yaz-gear/haptic-feedback-data-glove/hardware/cad_models/3D printed model/picture/final assembly 1.png

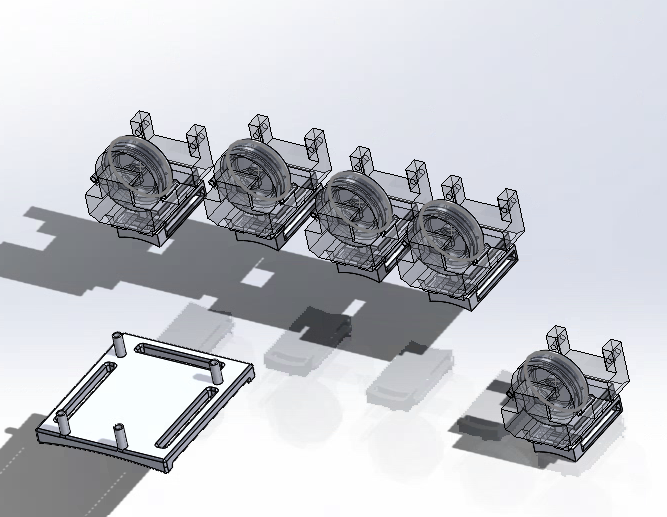
hardware/cad_models/3D printed model/picture/final assembly 1.png
