yaz-gear/haptic-feedback-data-glove/hardware/cad_models/3D printed model/picture/assembly 4.png

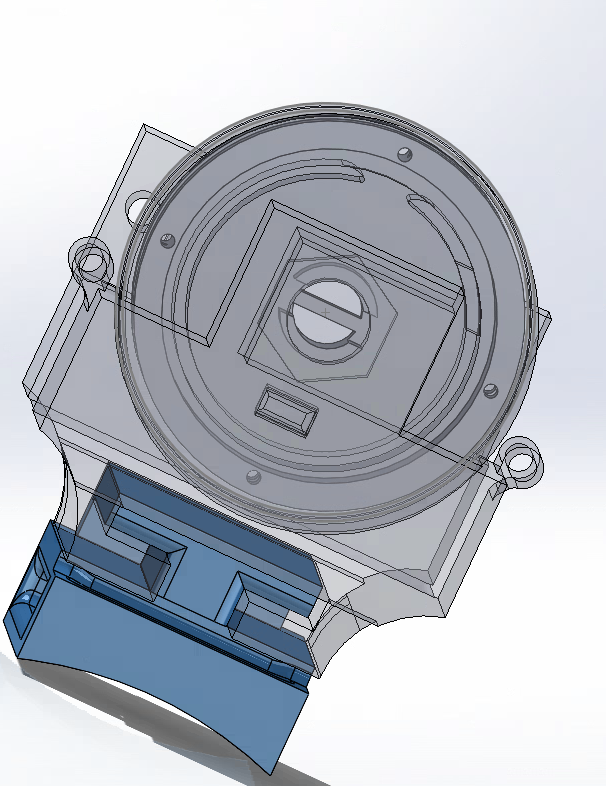
hardware/cad_models/3D printed model/picture/assembly 4.png
