yaz-gear/haptic-feedback-data-glove/docs/demo_images/data closed.jpg

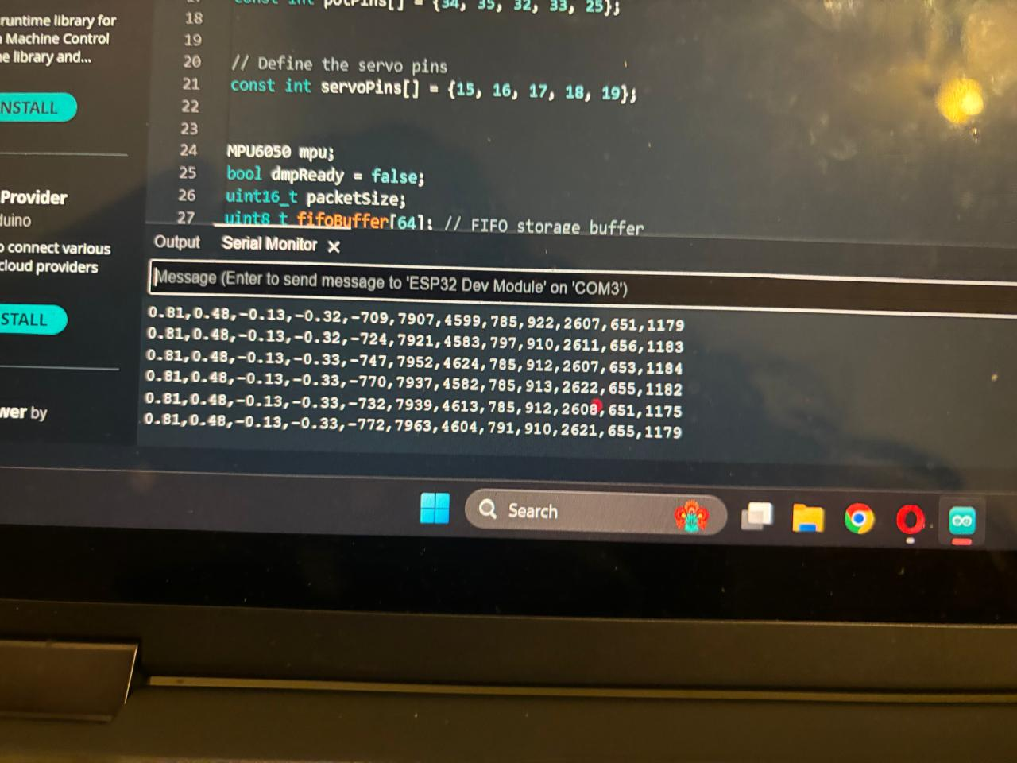
docs/demo_images/data closed.jpg
