yaz-gear/haptic-feedback-data-glove/docs/demo_images/data open.jpg

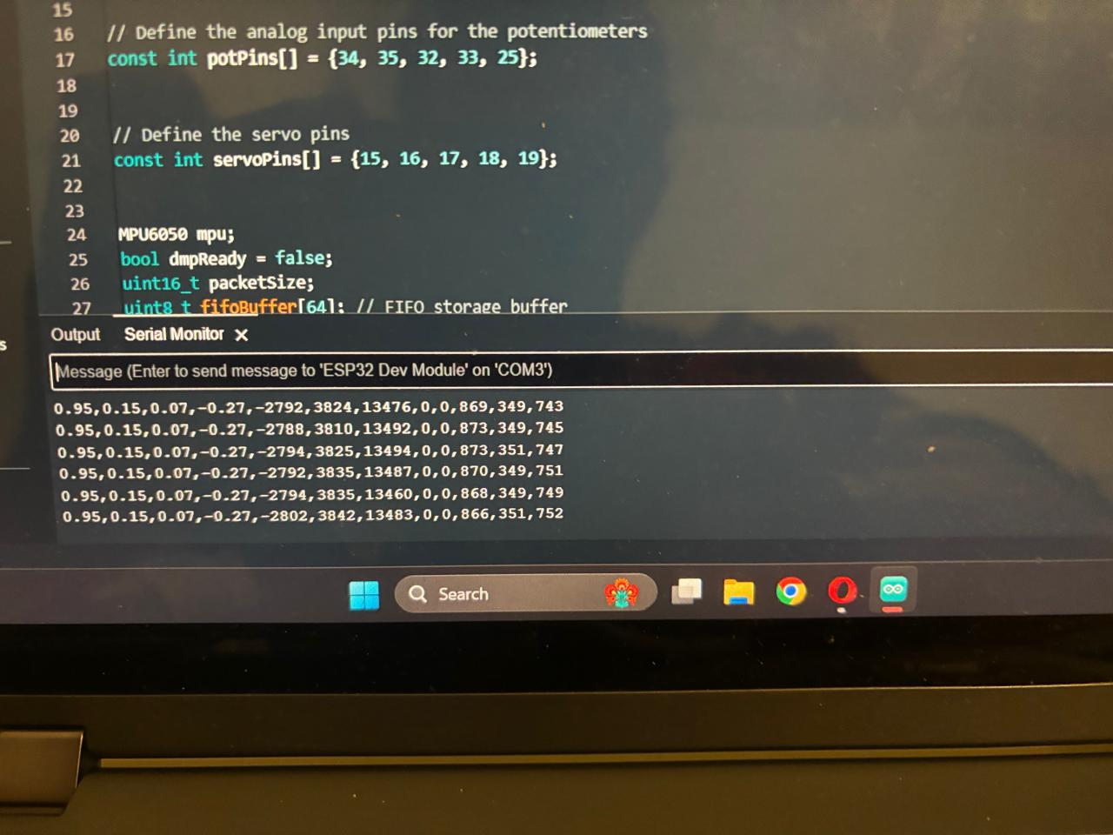
docs/demo_images/data open.jpg
