yaz-gear/haptic-feedback-data-glove/docs/demo_images/final glove closed.jpg

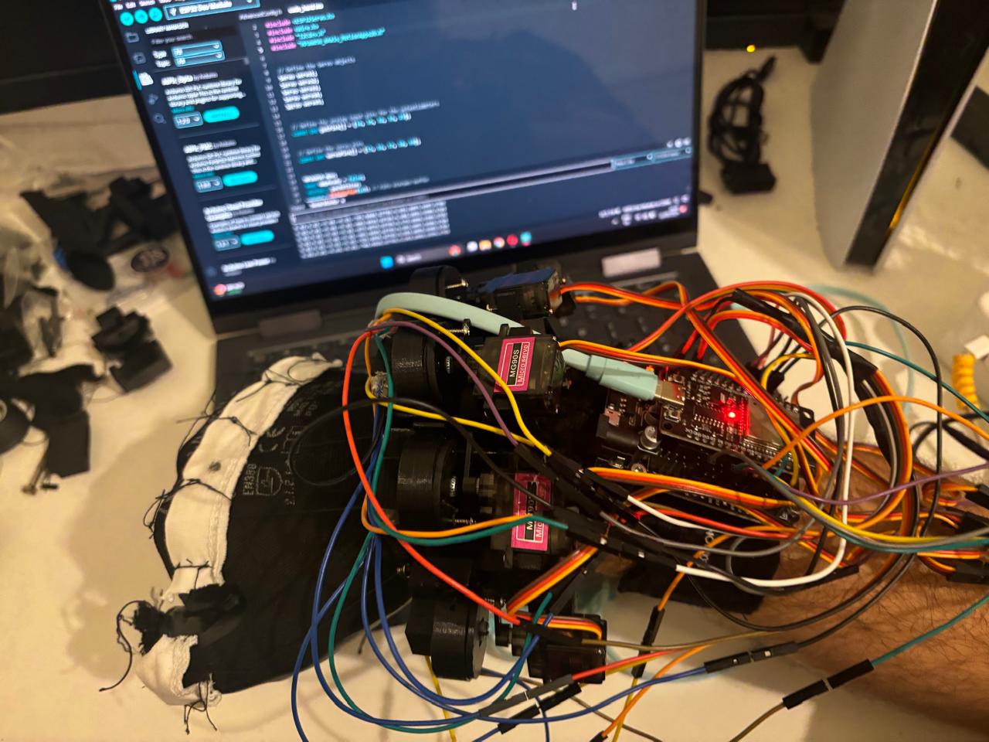
docs/demo_images/final glove closed.jpg
