yaz-gear/haptic-feedback-data-glove/docs/demo_images/final glove open.jpg

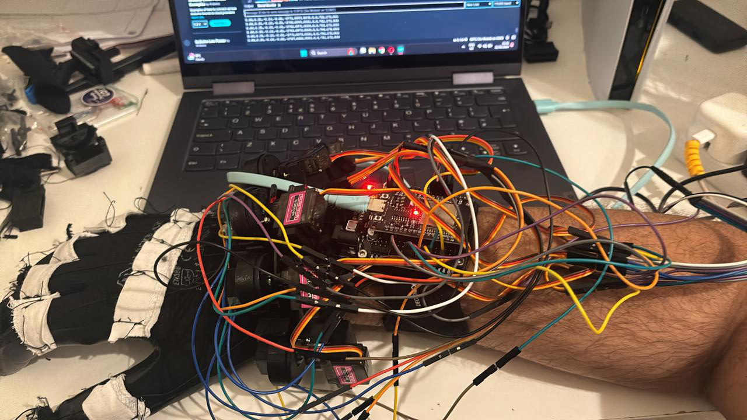
docs/demo_images/final glove open.jpg
