yaz-gear/haptic-feedback-data-glove/docs/demo_images/Screenshot 2024-08-22 215716.png

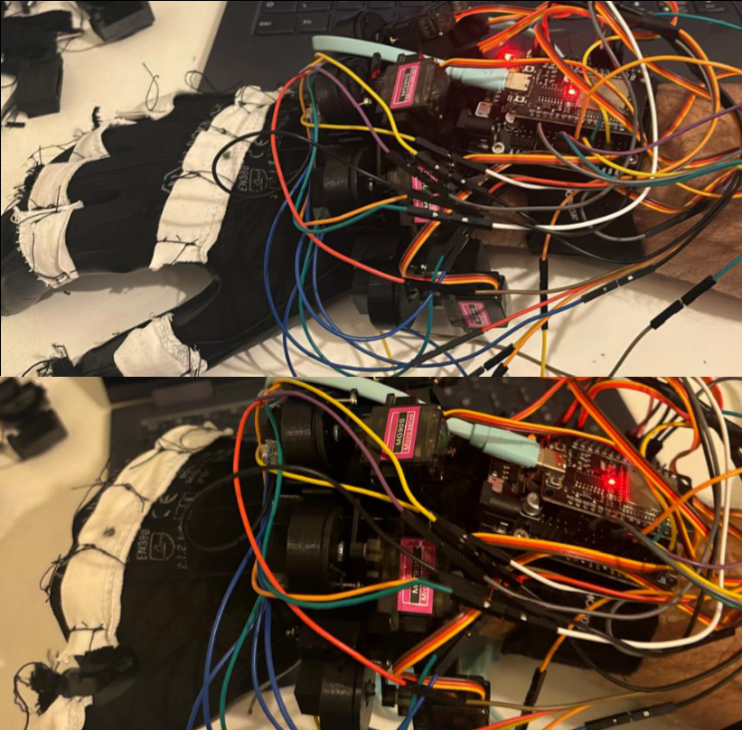
docs/demo_images/Screenshot 2024-08-22 215716.png
