yaz-gear/haptic-feedback-data-glove/docs/demo_images/unity hand closed.png

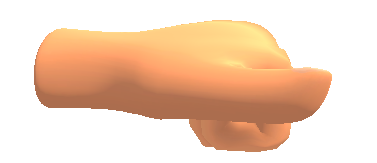
docs/demo_images/unity hand closed.png
