yaz-gear/haptic-feedback-data-glove/docs/demo_images/unity hand open.png

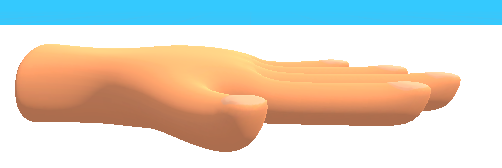
docs/demo_images/unity hand open.png
