yaz-gear/haptic-feedback-data-glove/docs/cost and data/components.pdf

The list of components and their links:

ESP32:

https://www.amazon.co.uk/gp/product/B0BY29C528/ref=ox_sc_act_title_4?smid=A1RRESHOTNJOS4&psc=1 (https://www.amazon.co.uk/gp/product/B0BY29C528/ref=ox_sc_act_title_4?smid=A1RRESHOTNJOS4&psc=1)

Potentiometers:

https://www.amazon.co.uk/gp/product/B07SVLZNYP/ref=ox_sc_act_title_5?smid=AIF4G7PLKBOZY&psc=1 (https://www.amazon.co.uk/gp/product/B07SVLZNYP/ref=ox_sc_act_title_5?smid=AIF4G7PLKBOZY&psc=1)

Servo Motors:

https://www.amazon.co.uk/gp/product/B093LFBWTL/ref=ox_sc_act_title_6?smid=AQOJP59OJWBHK&psc=1 (https://www.amazon.co.uk/gp/product/B093LFBWTL/ref=ox_sc_act_title_6?smid=AQOJP59OJWBHK&psc=1)

MPU:

https://www.amazon.co.uk/gp/product/B07XRK5FHP/ref=ox_sc_act_title_3?smid=A1A7E5ILEFA1R3&psc=1 (https://www.amazon.co.uk/gp/product/B07XRK5FHP/ref=ox_sc_act_title_3?smid=A1A7E5ILEFA1R3&psc=1)

Jumper Cable:

https://www.amazon.co.uk/gp/product/B01EV70C78/ref=ox_sc_act_title_2?smid=AZF7WYXU5ZANW&psc=1 (https://www.amazon.co.uk/gp/product/B01EV70C78/ref=ox_sc_act_title_2?smid=AZF7WYXU5ZANW&psc=1)

Glove:

https://www.amazon.co.uk/gp/product/B0053PXYDM/ref=ox_sc_act_title_1?smid=A3P5ROKL5A1OLE&psc=1 (https://www.amazon.co.uk/gp/product/B0053PXYDM/ref=ox_sc_act_title_1?smid=A3P5ROKL5A1OLE&psc=1)

Badge reels:

https://www.amazon.co.uk/gp/product/B07MD731BD/ref=ox_sc_act_title_7?smid=A1DGGI90Q1T2NC&psc=1 (https://www.amazon.co.uk/gp/product/B07MD731BD/ref=ox_sc_act_title_7?smid=A1DGGI90Q1T2NC&psc=1)

Power bank:

https://www.amazon.co.uk/dp/B0D4MDHB21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 (https://www.amazon.co.uk/dp/B0D4MDHB21?skipTwisterOG=1)

Velcro strap:

https://www.amazon.co.uk/Velcro-Brand-Multiples-Continuous-Length/dp/B00X1D973E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 Co88ZsXotGGMamFUGNqwyhC6eLfaLgupNPgdE7ohxcCkTx7Ffuvsc9T7ry0s9coV10S9w800c-B6Z79Xiw2PUi5jQ0ew6P_jVGrkeaRw9BqyYC9A_WWJQ3GzQqOSZoBlEKCHVaXhDF6dsD Xw0Nubd89dg1SD_EcKzsLlrAnonqTsf6RPbnGUZNfaamTFCn6ce2U_jHJOjtPrunySwgcYl134 kjUlrs-Q3G-h_x9mudlQO0SK-Rwd_PdbHF_d1sCfOjKTKdkRlJf04y8nZPhPejpRmMc1b1IAtiE.tCb6KLqEajr1-JF0RTCnmVC-Uk6lkMul4zrX_MTSca0&dib_tag=se&keywords=black+velcro&qid=1723662629&sprefix=blac k+velcro%2Caps%2C79&sr=8-2-spons&sp_csd=d2lkZ2V0TmFtZT1zcF9hdGY&psc=1 (https://www.amazon.co.uk/Velcro-Brand-Multiples-Continuous-Length/dp/B00X1D973E?sp_csd=d2lkZ2V0TmFtZT1zcF9hdGY)
