yaz-gear/haptic-feedback-data-glove/docs/cost and data/Screenshot 2024-08-24 203508.png

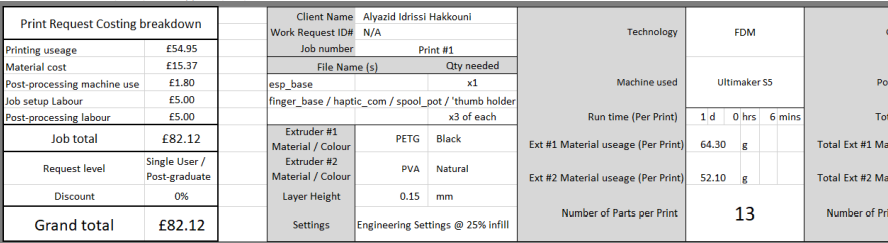
docs/cost and data/Screenshot 2024-08-24 203508.png
