yaz-gear/haptic-feedback-data-glove/hardware/cad_models/other designs and proposals/Assemre.SLDASM

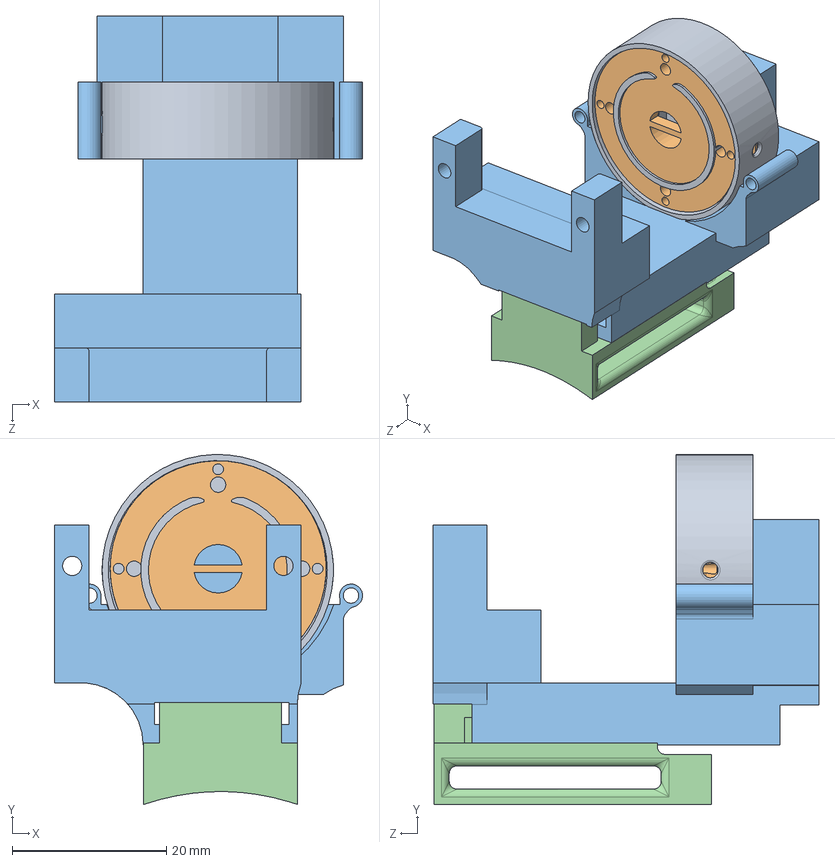
[picture p16: CAD file, 2026-01-20]
hardware/cad_models/other designs and proposals/Assemre.SLDASM
40.0 x 45.4 x 50.0 mm
haptic_com_2
spool_pot_2
finger_base_2
thumb holder
