yaz-gear/haptic-feedback-data-glove/hardware/cad_models/other designs and proposals/wire module.SLDASM

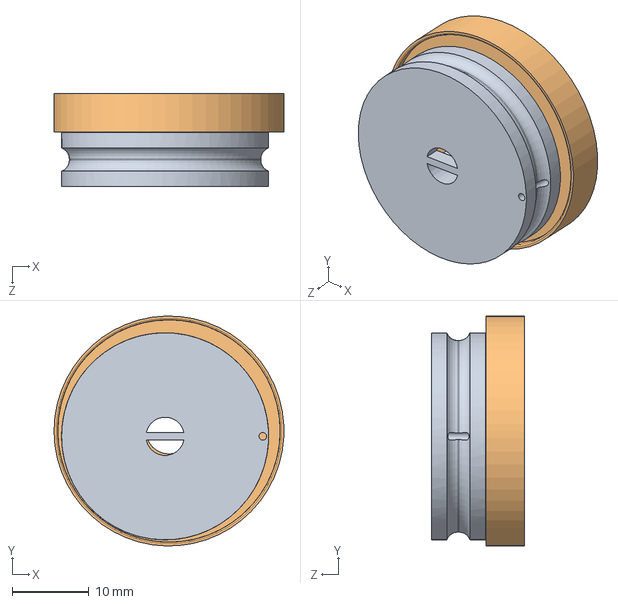
[picture p17: CAD file, 2026-01-20]
hardware/cad_models/other designs and proposals/wire module.SLDASM
30.0 x 30.0 x 12.1 mm
haptic_com
spool_pot
