yaz-gear/haptic-feedback-data-glove/hardware/cad_models/other designs and proposals/Assem1.SLDASM

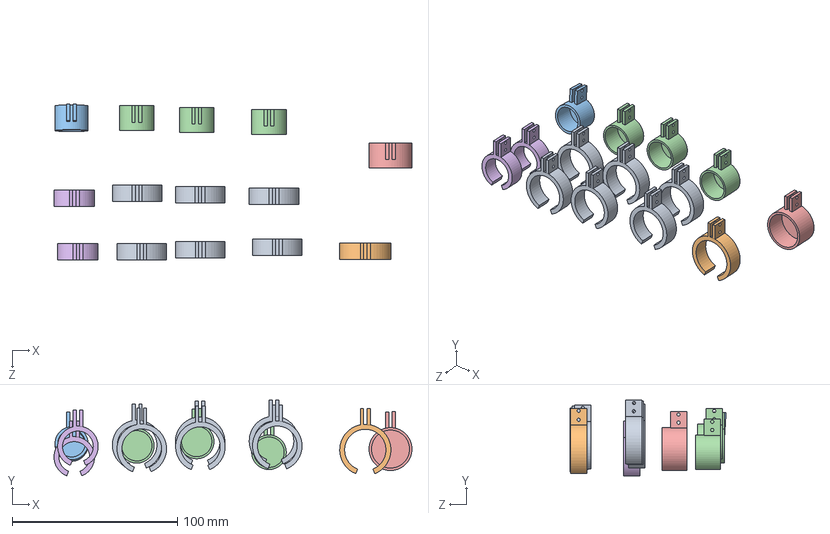
[picture p18: CAD file, 2026-01-20]
hardware/cad_models/other designs and proposals/Assem1.SLDASM
216.6 x 45.8 x 94.6 mm
middle fingers x 6
thumb finger
pinky end
three midle finger end x 3
thumb end
pinky finger x 2
