yaz-gear/haptic-feedback-data-glove/hardware/cad_models/other designs and proposals/final_assem.SLDASM

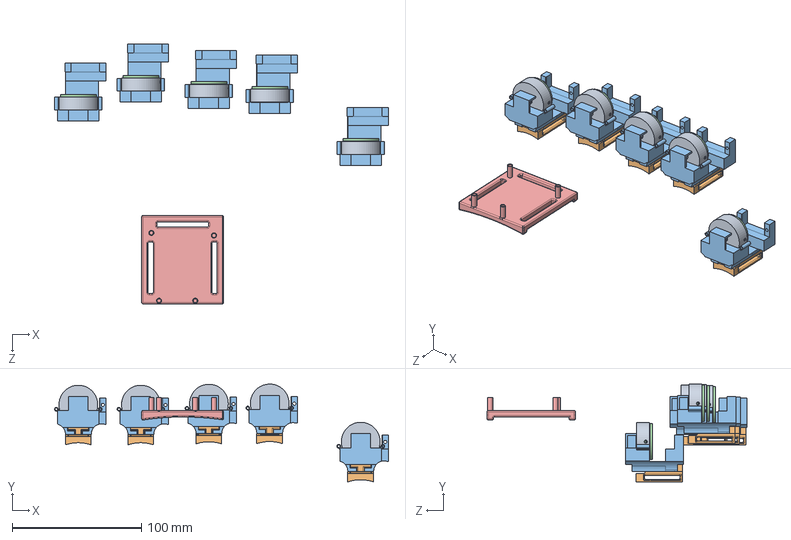
[picture p19: CAD file, 2026-01-20]
hardware/cad_models/other designs and proposals/final_assem.SLDASM
258.6 x 75.8 x 201.2 mm
thumb holder x 5
finger_base x 5
spool_pot x 5
haptic_com x 5
esp_base
