yaz-gear/haptic-feedback-data-glove/hardware/cad_models/3D printed model/finger_base_2.SLDPRT

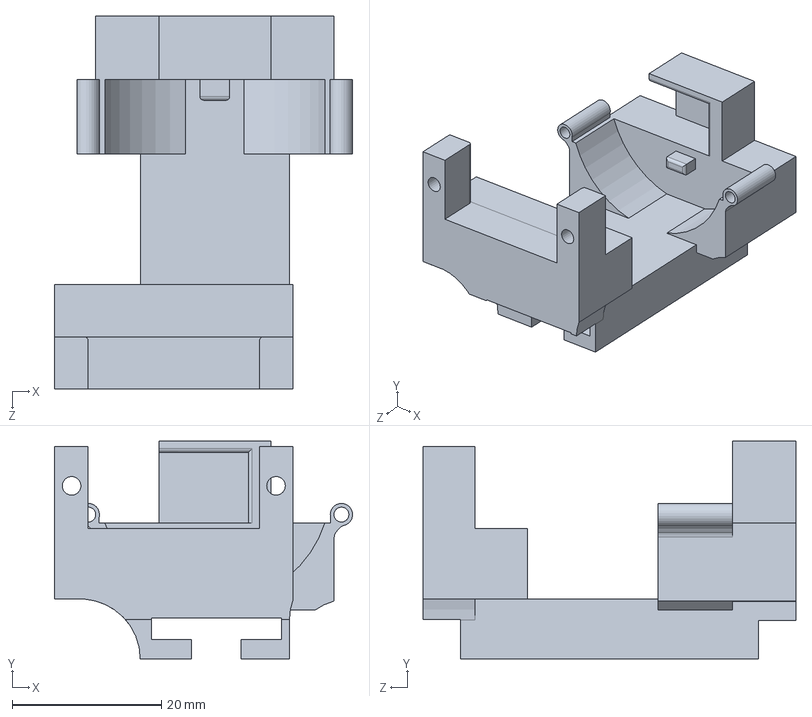
[picture p20: CAD file, 2026-01-20]
hardware/cad_models/3D printed model/finger_base_2.SLDPRT
40.0 x 29.2 x 50.0 mm
