yaz-gear/haptic-feedback-data-glove/hardware/cad_models/other designs and proposals/three midle finger end.SLDPRT

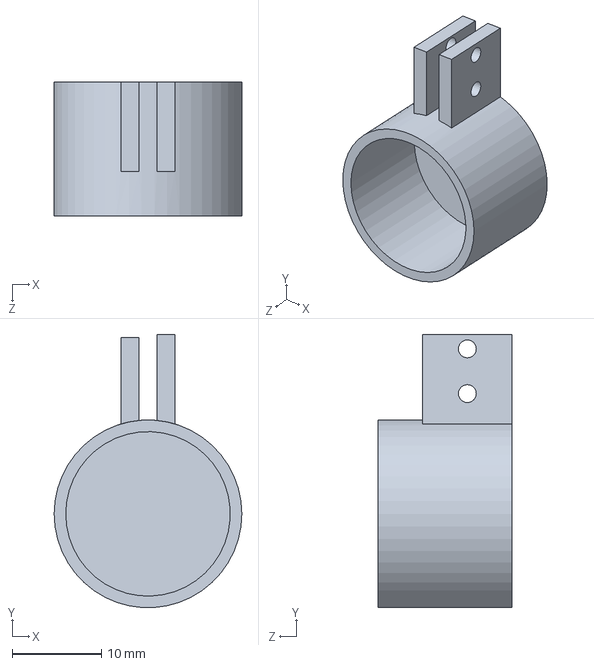
[picture p21: CAD file, 2026-01-20]
hardware/cad_models/other designs and proposals/three midle finger end.SLDPRT
21.0 x 30.5 x 15.0 mm
