yaz-gear/haptic-feedback-data-glove/hardware/cad_models/stl/haptic_com.STL

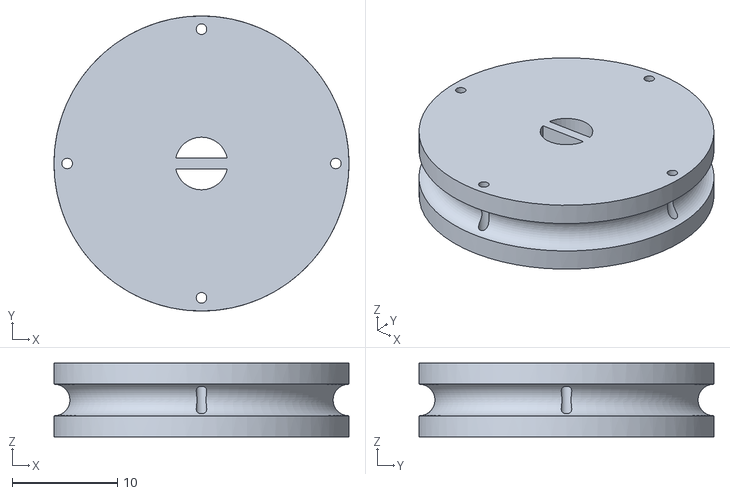
[picture p22: CAD file, 2026-01-20]
hardware/cad_models/stl/haptic_com.STL
28.0 x 28.0 x 7.00
