yaz-gear/haptic-feedback-data-glove/hardware/cad_models/3D printed model/esp_base.SLDPRT

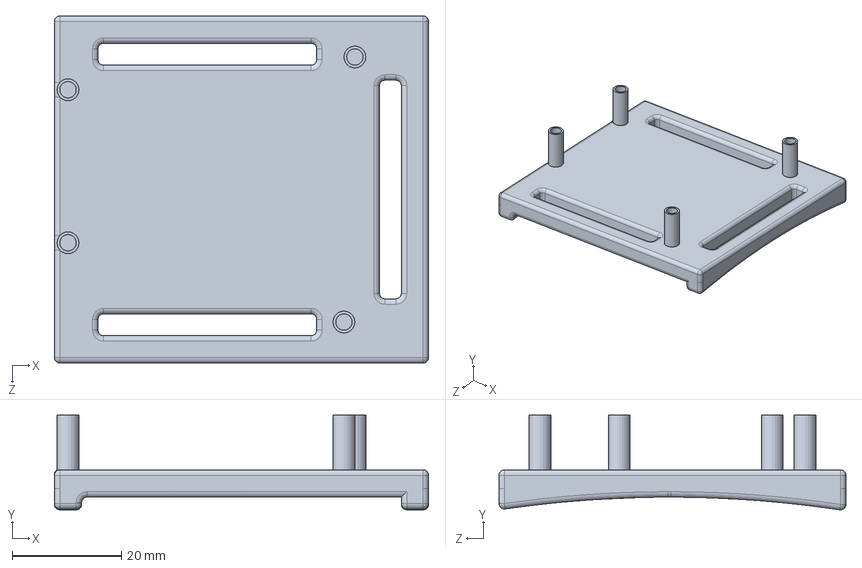
[picture p23: CAD file, 2026-01-20]
hardware/cad_models/3D printed model/esp_base.SLDPRT
68.5 x 17.3 x 63.5 mm
