yaz-gear/haptic-feedback-data-glove/hardware/cad_models/other designs and proposals/pinky end.SLDPRT

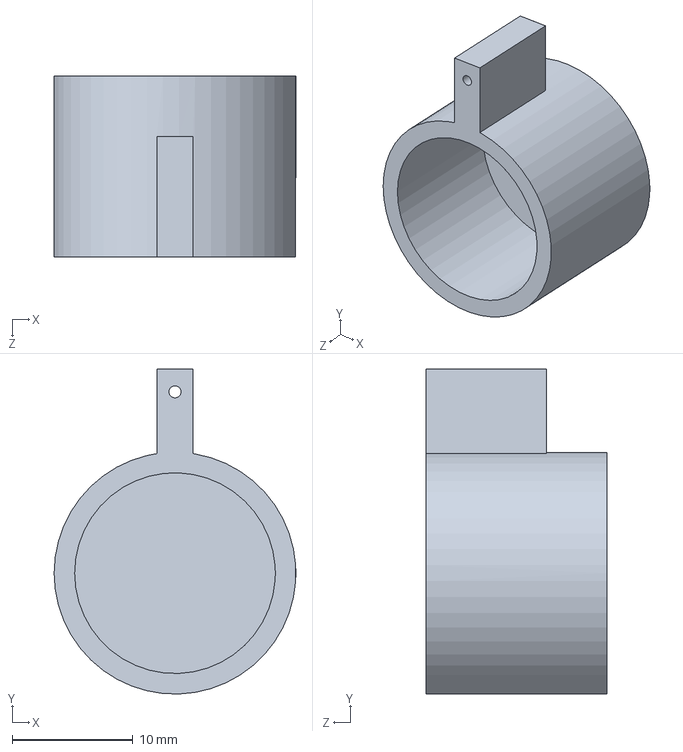
[picture p24: CAD file, 2026-01-20]
hardware/cad_models/other designs and proposals/pinky end.SLDPRT
20.0 x 26.9 x 15.0 mm
