yaz-gear/haptic-feedback-data-glove/hardware/cad_models/stl/thumb holder2.STL

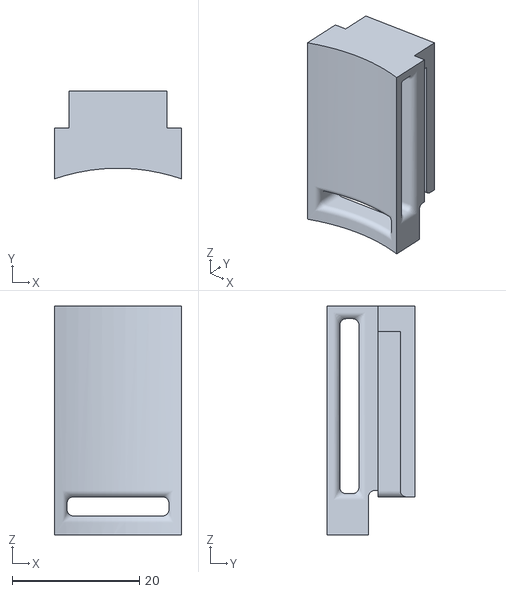
[picture p25: CAD file, 2026-01-20]
hardware/cad_models/stl/thumb holder2.STL
20.0 x 13.8 x 36.0
