yaz-gear/haptic-feedback-data-glove/hardware/cad_models/3D printed model/spool_pot_2.SLDPRT

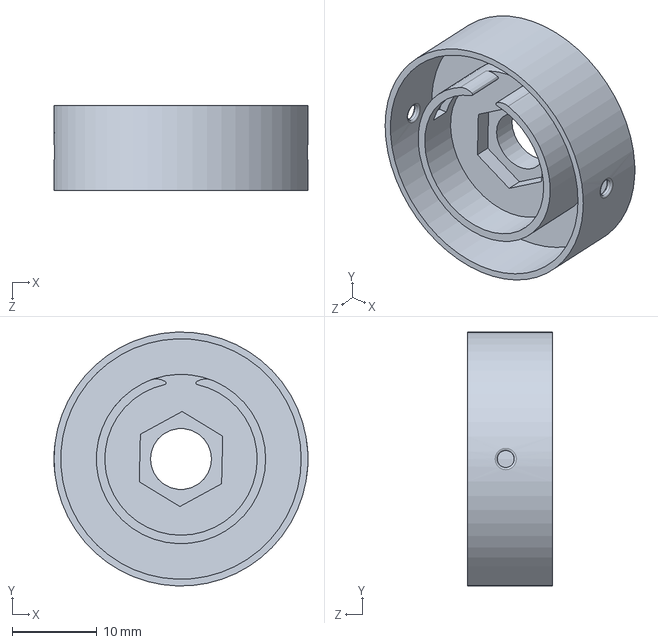
[picture p26: CAD file, 2026-01-20]
hardware/cad_models/3D printed model/spool_pot_2.SLDPRT
30.0 x 30.0 x 10.0 mm
