yaz-gear/haptic-feedback-data-glove/hardware/cad_models/stl/finger_base.STL

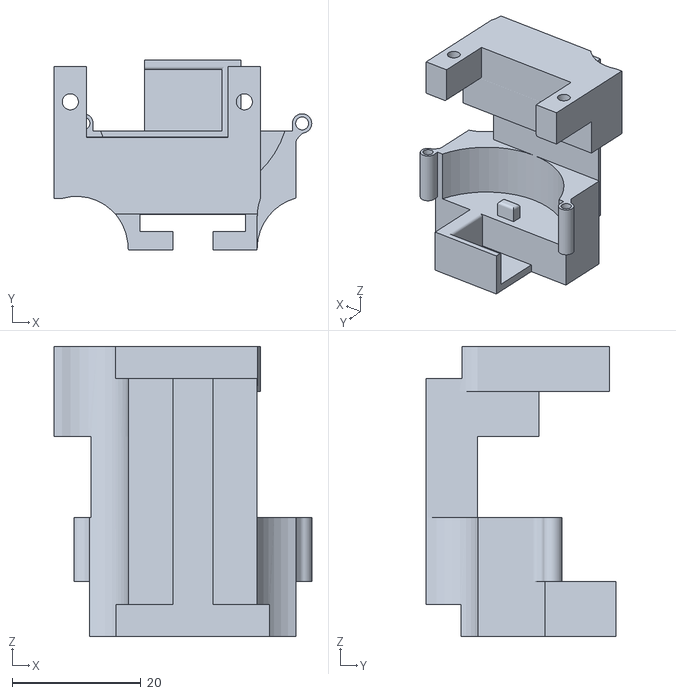
[picture p27: CAD file, 2026-01-20]
hardware/cad_models/stl/finger_base.STL
40.0 x 29.5 x 45.0
