yaz-gear/haptic-feedback-data-glove/hardware/cad_models/other designs and proposals/thumb finger.SLDPRT

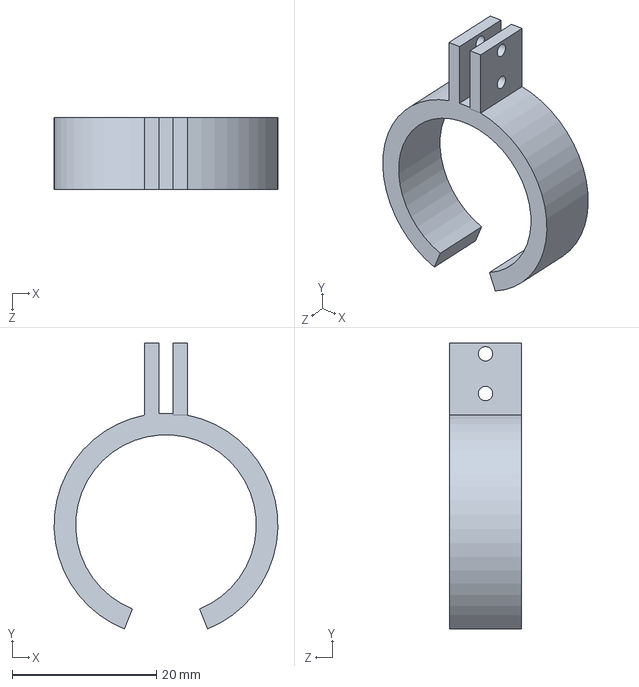
[picture p28: CAD file, 2026-01-20]
hardware/cad_models/other designs and proposals/thumb finger.SLDPRT
31.0 x 39.6 x 10.0 mm
