yaz-gear/haptic-feedback-data-glove/hardware/cad_models/stl/thumb holder.STL

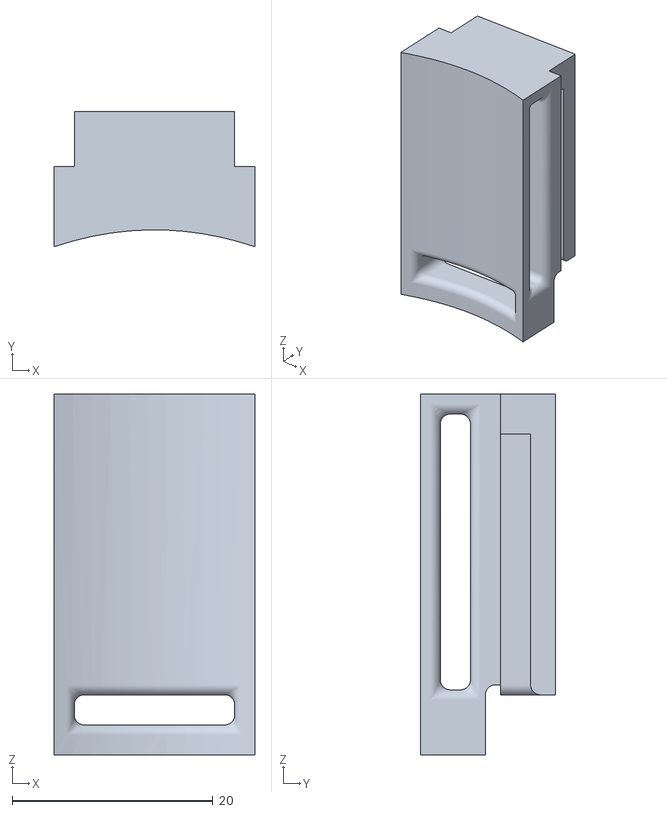
[picture p29: CAD file, 2026-01-20]
hardware/cad_models/stl/thumb holder.STL
20.0 x 13.5 x 36.0
