yaz-gear/haptic-feedback-data-glove/hardware/cad_models/other designs and proposals/pinky finger.SLDPRT

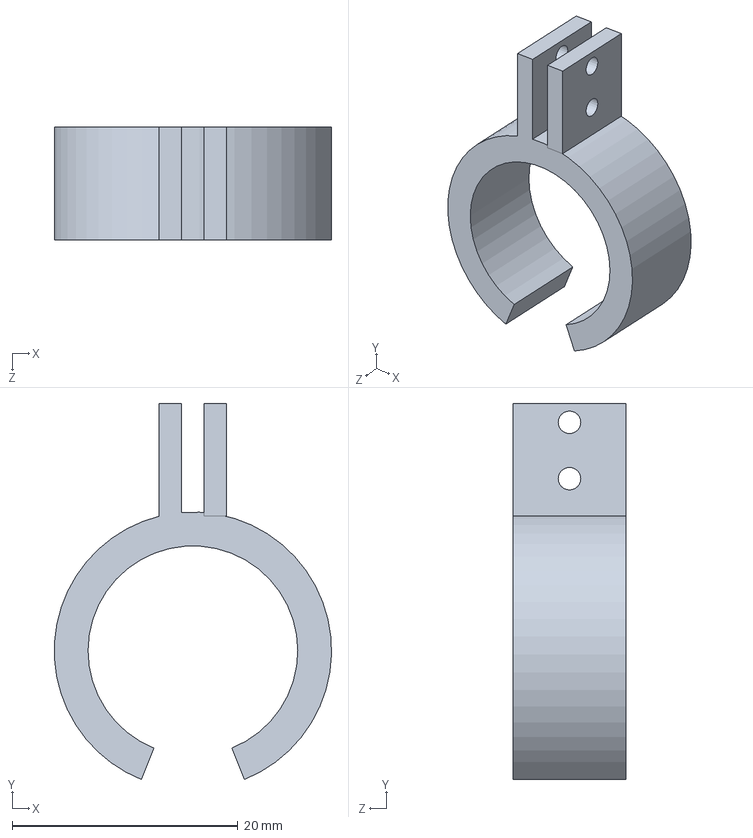
[picture p30: CAD file, 2026-01-20]
hardware/cad_models/other designs and proposals/pinky finger.SLDPRT
24.6 x 33.3 x 10.0 mm
