yaz-gear/haptic-feedback-data-glove/hardware/cad_models/stl/spool_pot.STL

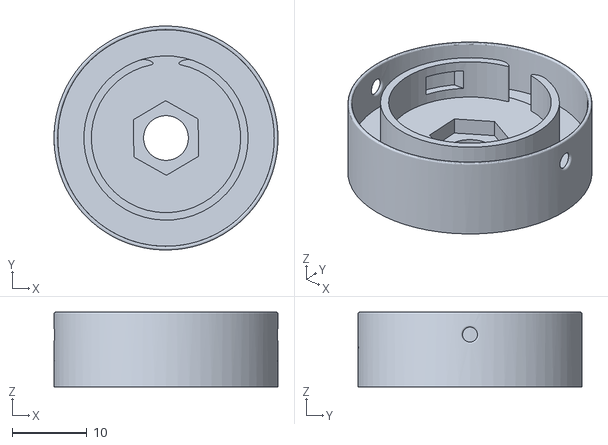
[picture p31: CAD file, 2026-01-20]
hardware/cad_models/stl/spool_pot.STL
30.0 x 30.0 x 10.0
