yaz-gear/haptic-feedback-data-glove/hardware/cad_models/other designs and proposals/middle fingers.SLDPRT

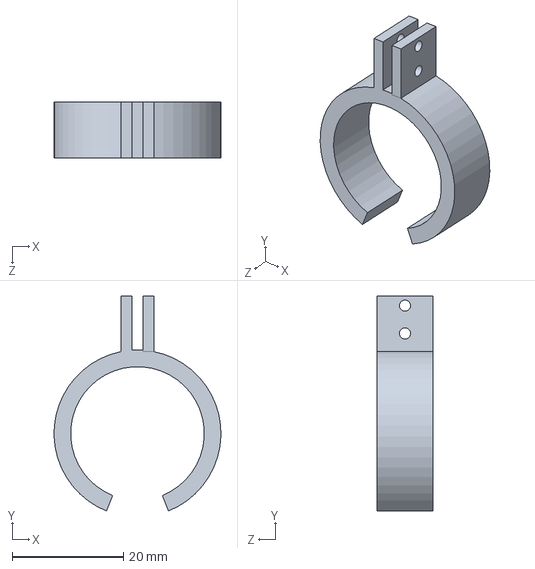
[picture p32: CAD file, 2026-01-20]
hardware/cad_models/other designs and proposals/middle fingers.SLDPRT
30.0 x 38.6 x 10.0 mm
