yaz-gear/haptic-feedback-data-glove/hardware/cad_models/other designs and proposals/thumb end.SLDPRT

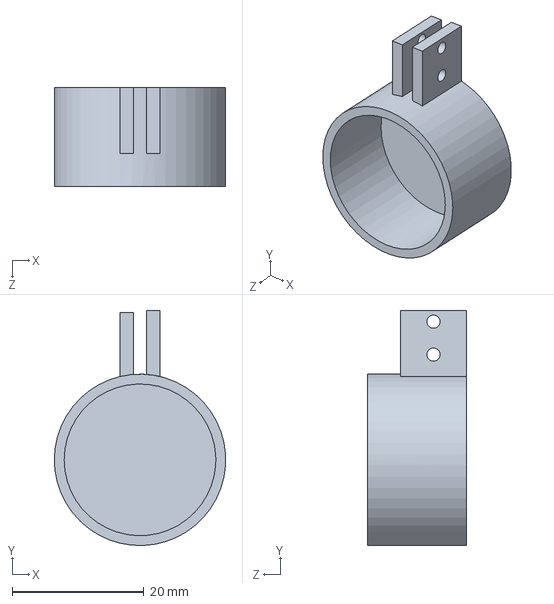
[picture p33: CAD file, 2026-01-20]
hardware/cad_models/other designs and proposals/thumb end.SLDPRT
26.0 x 35.6 x 15.0 mm
