yaz-gear/haptic-feedback-data-glove/hardware/cad_models/other designs and proposals/hand_holder.SLDPRT

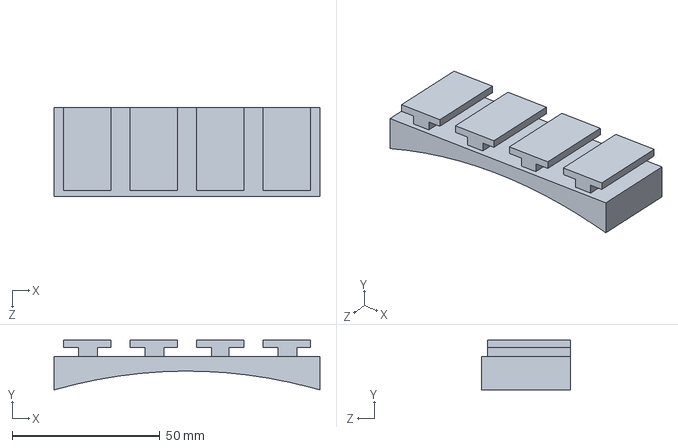
[picture p34: CAD file, 2026-01-20]
hardware/cad_models/other designs and proposals/hand_holder.SLDPRT
90.0 x 16.9 x 30.0 mm
