yaz-gear/haptic-feedback-data-glove/hardware/cad_models/other designs and proposals/roller joint.SLDPRT

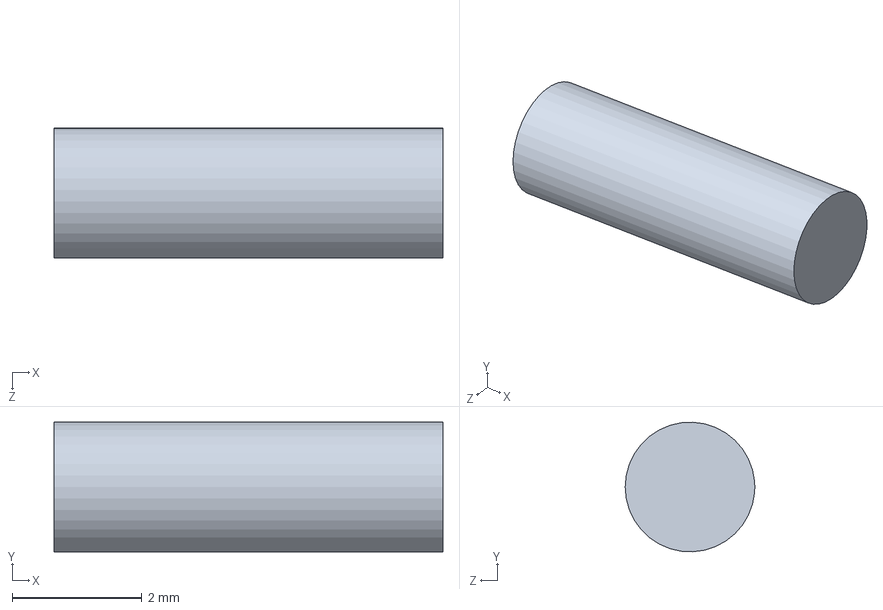
[picture p35: CAD file, 2026-01-20]
hardware/cad_models/other designs and proposals/roller joint.SLDPRT
6.00 x 2.00 x 2.00 mm
