yaz-gear/haptic-feedback-data-glove/hardware/cad_models/other designs and proposals/roller.SLDPRT

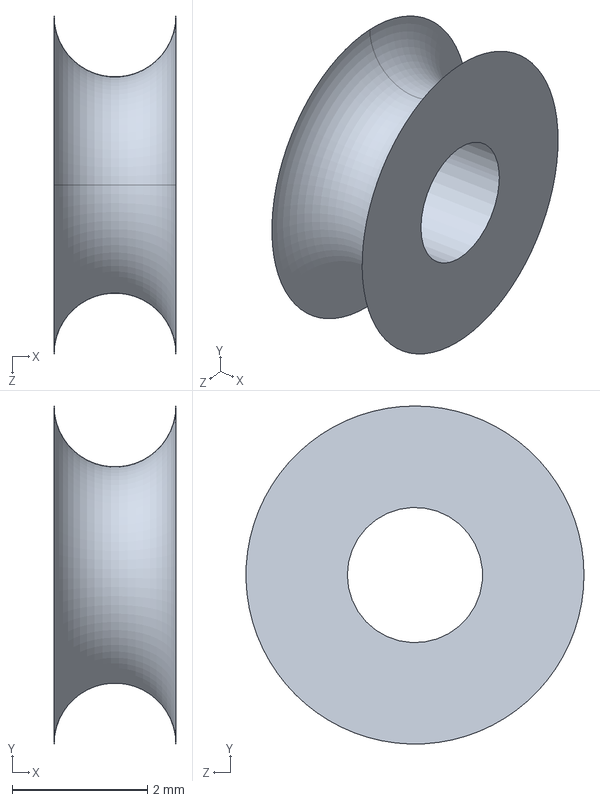
[picture p36: CAD file, 2026-01-20]
hardware/cad_models/other designs and proposals/roller.SLDPRT
1.80 x 5.00 x 5.00 mm
