yaz-gear/haptic-feedback-data-glove/(list of files, cad)

Other CAD files:
hardware/cad_models/_$final_assem.SLDASM
hardware/cad_models/_$Assem1.SLDASM
hardware/cad_models/_$wire module.SLDASM
hardware/cad_models/other designs and proposals/haptic_com.SLDPRT
hardware/cad_models/stl/haptic_com_2.STL
hardware/cad_models/3D printed model/haptic_com_2.SLDPRT
hardware/cad_models/_$hand_holder.SLDPRT
hardware/cad_models/3D printed model/thumb holder.SLDPRT
hardware/cad_models/stl/finger_base_2.STL
hardware/cad_models/stl/esp_base.STL
hardware/cad_models/stl/spool_pot_2.STL
hardware/cad_models/other designs and proposals/spool_pot.SLDPRT
hardware/cad_models/other designs and proposals/finger_base.SLDPRT
