yaz-gear/haptic-feedback-data-glove/docs/cost and data/thumbnail_3D printing cost -  Print #2 (FDM - PetG) - 16.08.2024.png

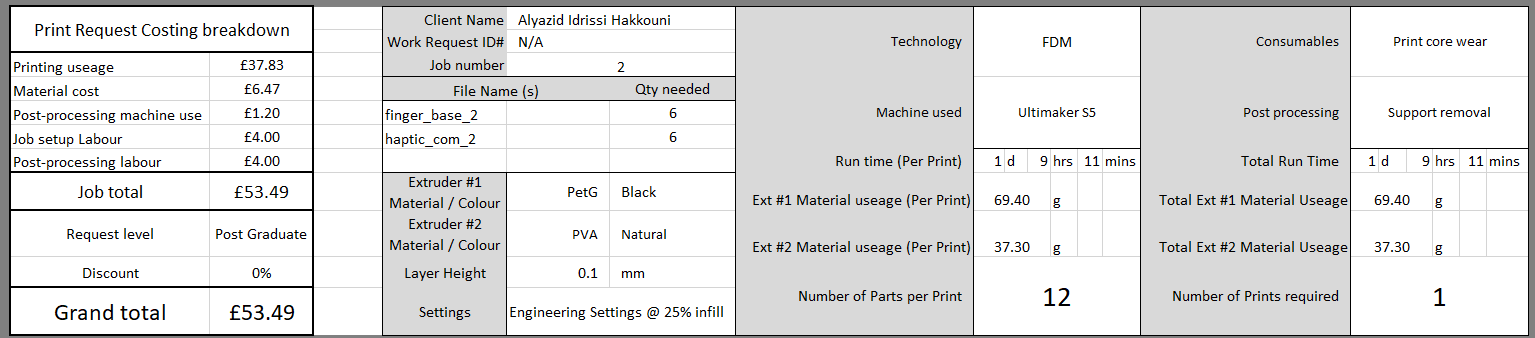
docs/cost and data/thumbnail_3D printing cost - Print #2 (FDM - PetG) - 16.08.2024.png
