yaz-gear/haptic-feedback-data-glove/hardware/cad_models/3D printed model/picture/final assembly 2.png

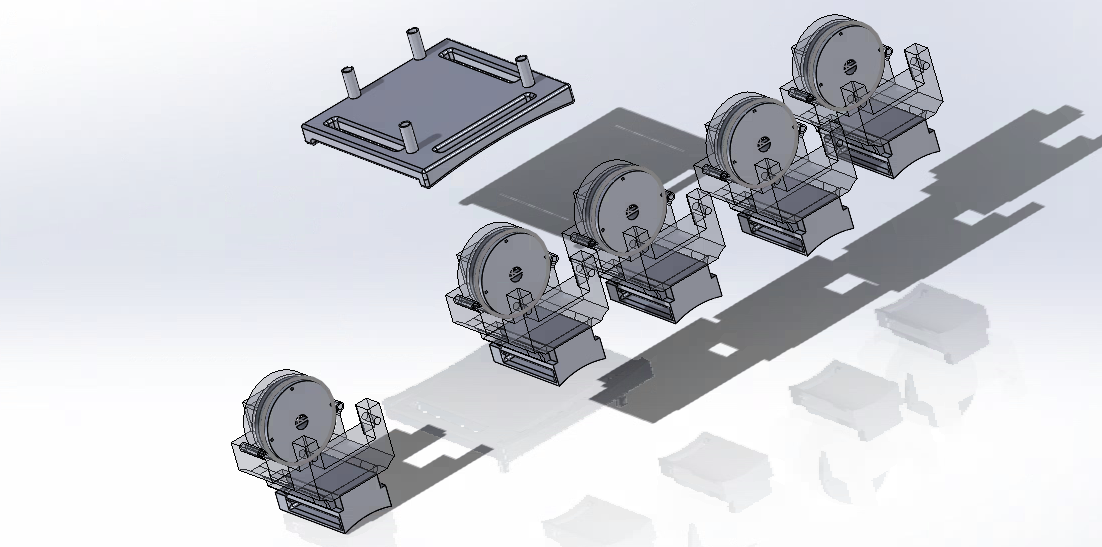
hardware/cad_models/3D printed model/picture/final assembly 2.png
