yaz-gear/haptic-feedback-data-glove/hardware/cad_models/3D printed model/picture/finger assembly 1.png

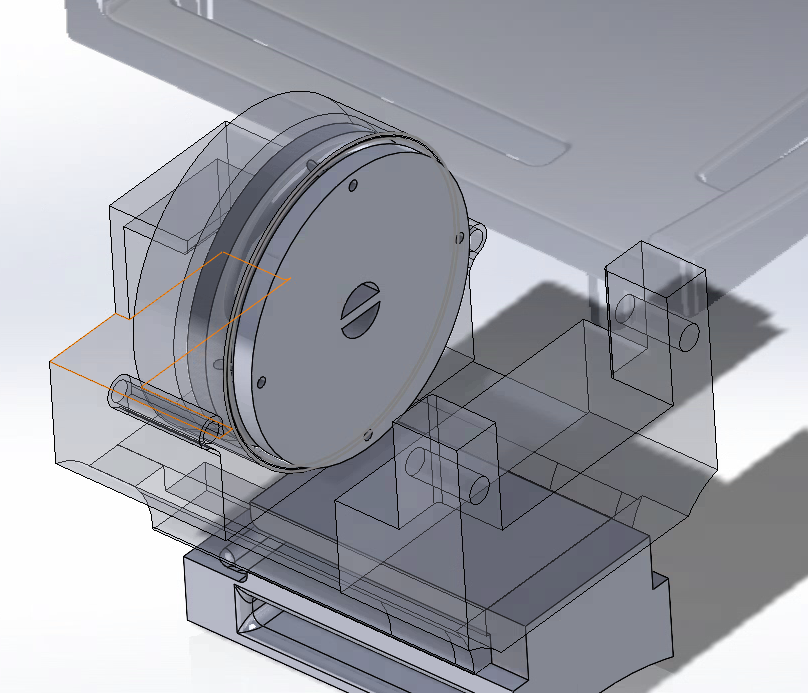
hardware/cad_models/3D printed model/picture/finger assembly 1.png
